AnikSarker/CSE-404-4-Bit-PC/Block.pdf

PC

4 | ACC 44 | 44

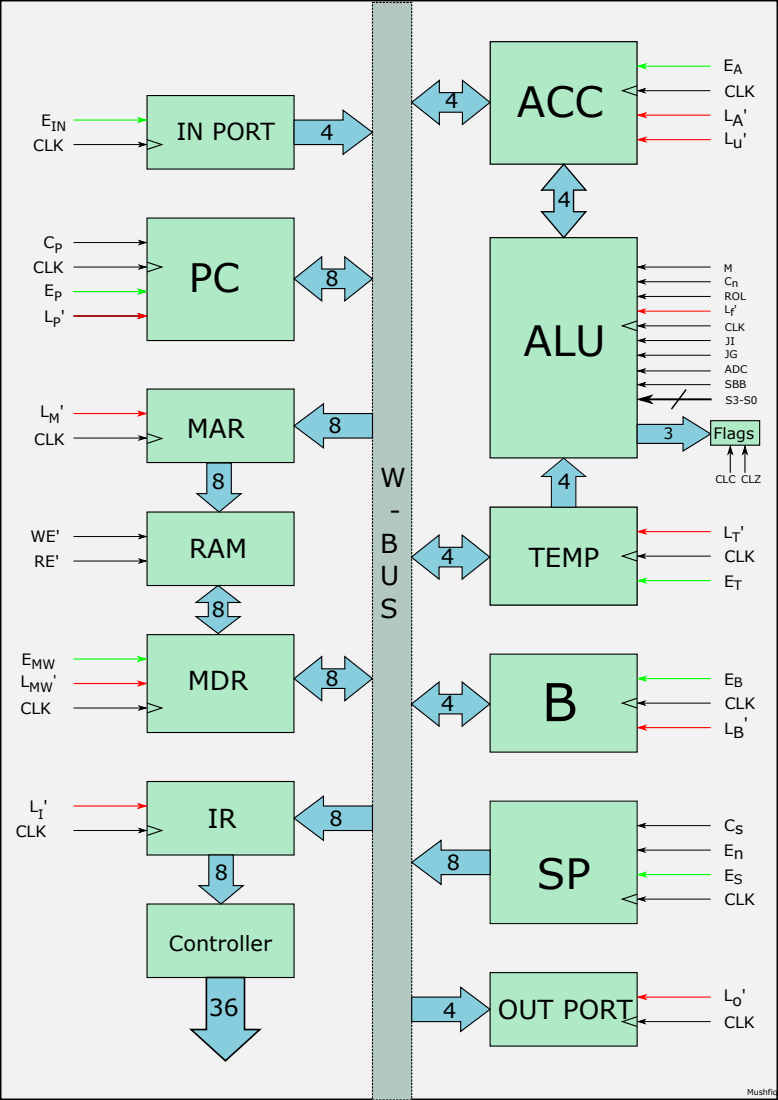
[picture p7: page 1]
IN PORT; MAR; RAM; MDR; Controller; EIN CLKCP; CLK; EMW LMW'; CLKLI'; Flags EA; CLK EB; ALU; TEMP B; OUT PORT; -BUS; Mushfiq; CLC CLZ; ACC 44; CLK LA' LT'; MC n ROL Lf'; CLK JI JG ADC SBB S3-S0

CLK LA' LT'

CLKEP LP' LM'

CLK LB' ES

CLK Cs En
CLK Lo'
