AnikSarker/CSE-404-4-Bit-PC/(list of files, drawings)

Other design files:
A1G1.pdsprj
